SihunHwang/wireless_communication/presentation/poster.jpeg

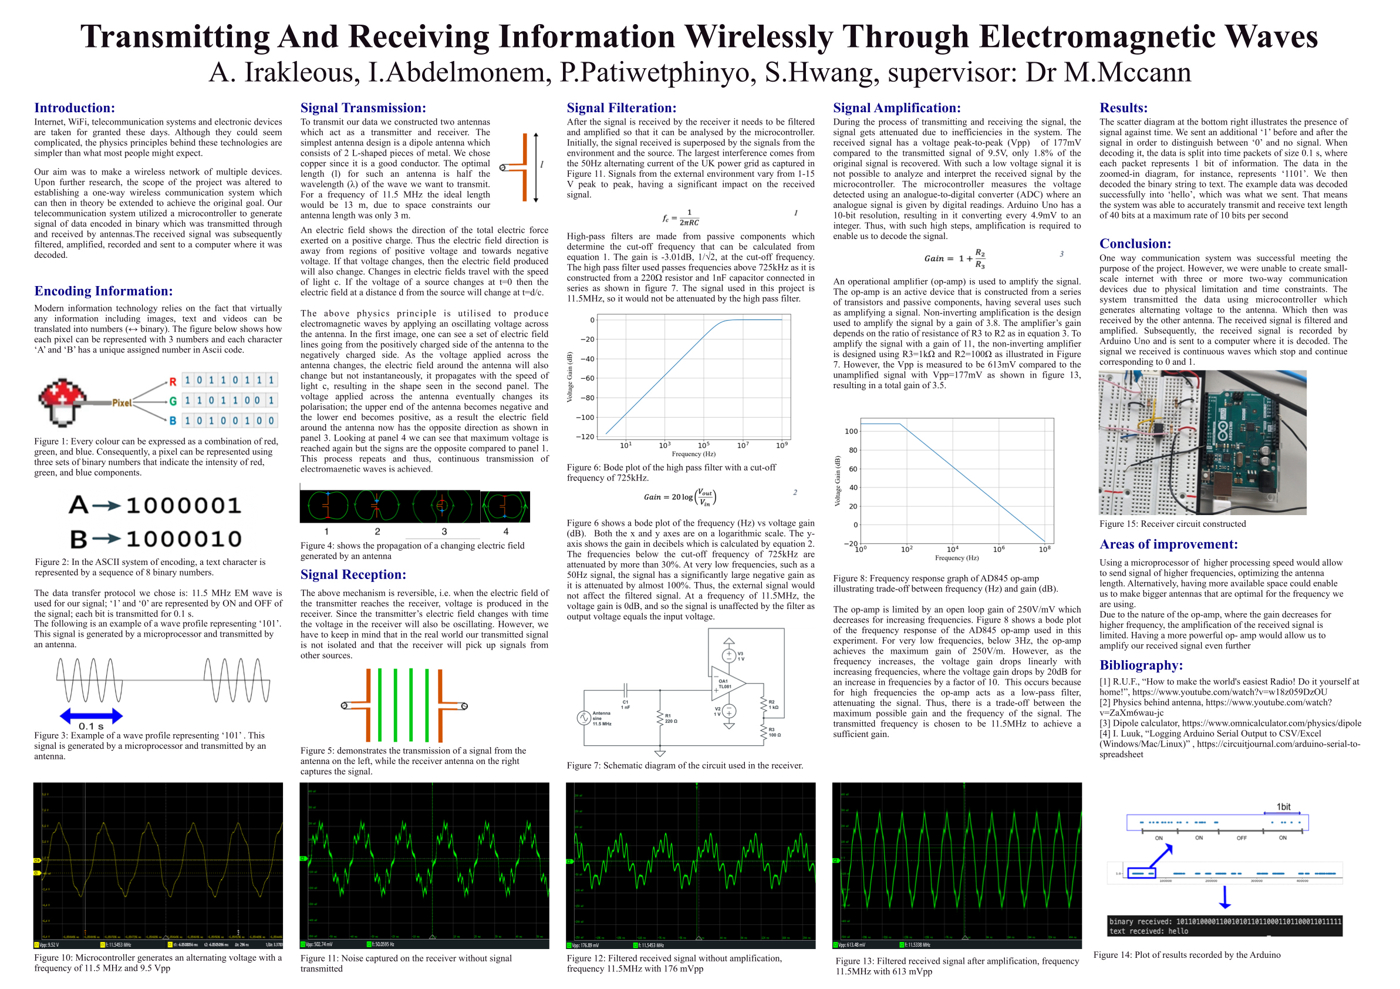
presentation/poster.jpeg
